bdebyl/kicad-stm32-reflow/stm32-reflow.kicad_pcb

## KiCad design stm32-reflow.kicad_pcb (2022-01-13)

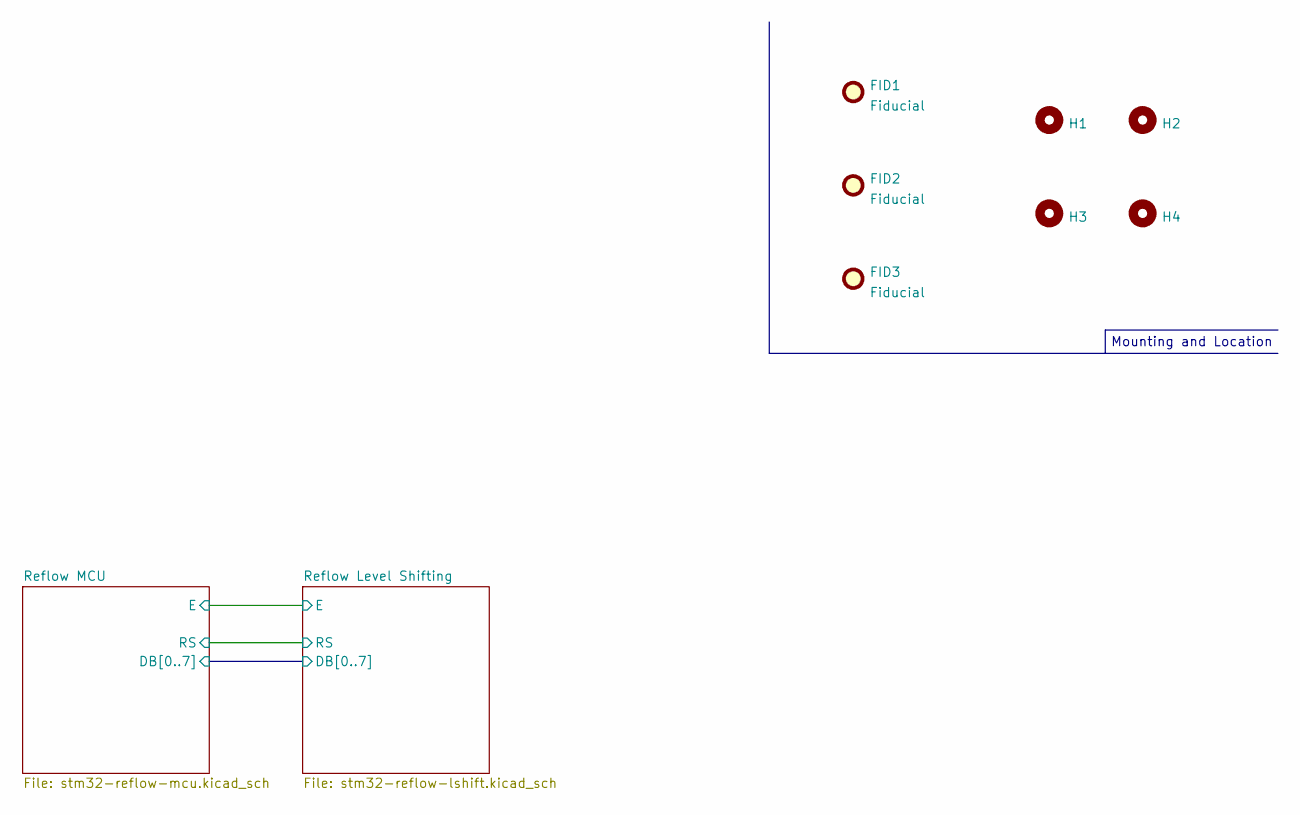
[picture p1: schematic stm32-reflow.kicad_sch, STM32 Reflow Controller]

Parts:
FID1, FID2, FID3: Fiducial; Fiducial_0.75mm_Mask2.25mm
H1, H2, H3, H4: MountingHole; MountingHole_2.7mm_M2.5_Pad_Via

Notes on the sheet:
Mounting and Location

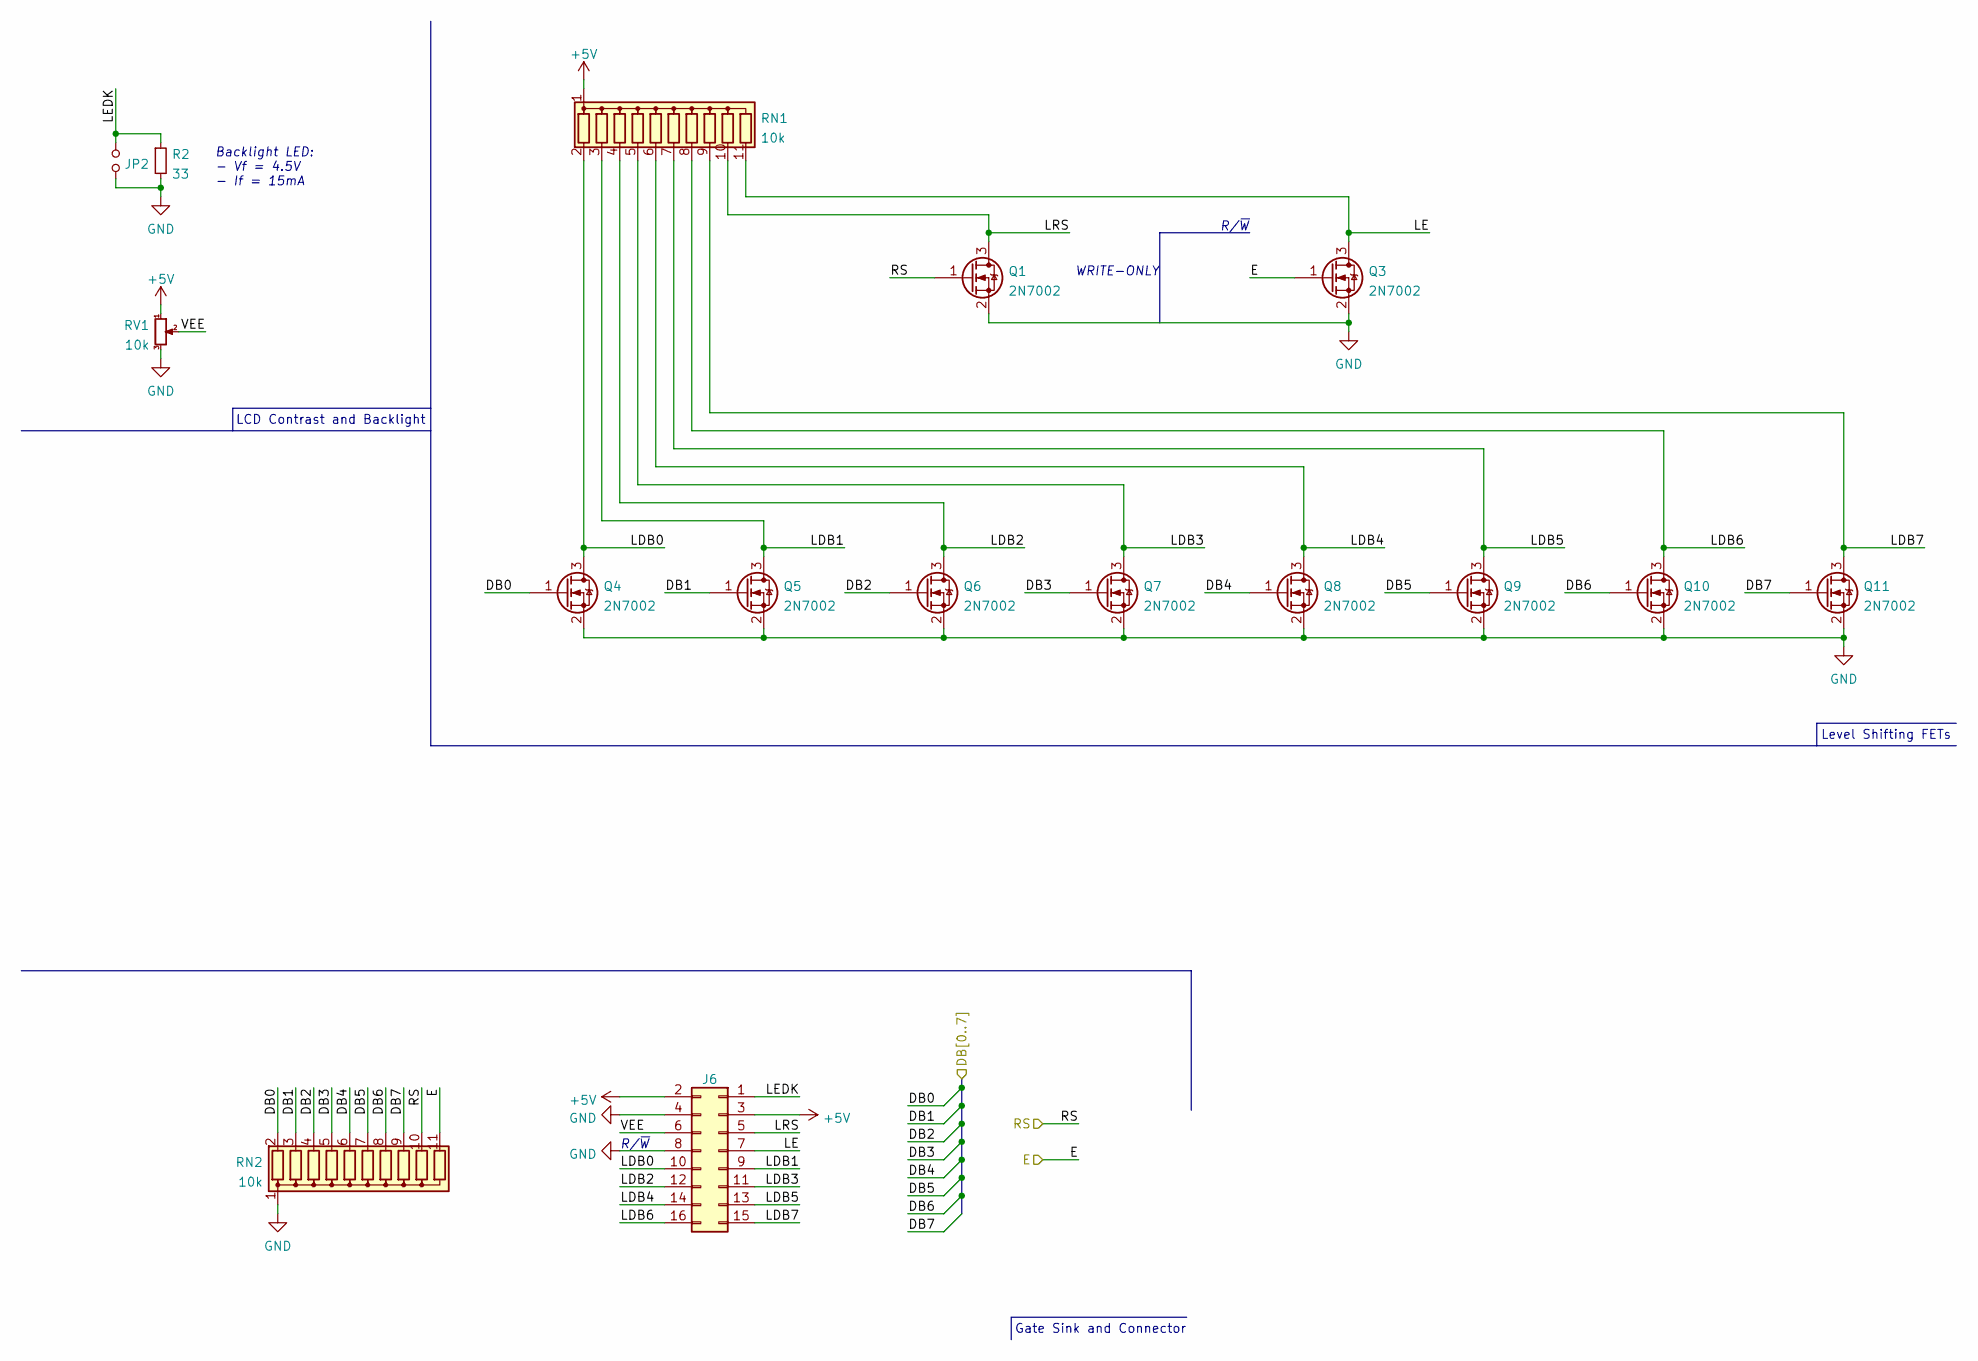
[picture p2: schematic stm32-reflow-lshift.kicad_sch, STM32 Reflow Controller]

Parts:
J6: Conn_02x08_Odd_Even; IDC-Header_2x08_P2.54mm_Vertical; DigiKey Part # S9171-ND
JP2: Jumper_NO_Small; SolderJumper-2_P1.3mm_Open_TrianglePad1.0x1.5mm
Q1, Q3, Q4, Q5, Q6, Q7, Q8, Q9, Q10, Q11: 2N7002; SOT-23; DigiKey Part # 1727-8642-1-ND
R2: 33; R_0805_2012Metric; DigiKey Part # RMCF0805JT33R0CT-ND
RN1, RN2: 10k; R_Array_SIP11; DigiKey Part # 4611X-101-103LF-ND
RV1: 10k; Potentiometer_Bourns_3314G_Vertical; DigiKey Part # ST4ETB103CT-ND

Connections:
+5V: J6.2, J6.3, RN1.1 (common), RV1.1; also elsewhere on the board
/Reflow Level Shifting/DB0: Q4.1 (G), RN2.2 (R1); also elsewhere on the board
/Reflow Level Shifting/DB1: Q5.1 (G), RN2.3 (R2); also elsewhere on the board
/Reflow Level Shifting/DB2: Q6.1 (G), RN2.4 (R3); also elsewhere on the board
/Reflow Level Shifting/DB3: Q7.1 (G), RN2.5 (R4); also elsewhere on the board
/Reflow Level Shifting/DB4: Q8.1 (G), RN2.6 (R5); also elsewhere on the board
/Reflow Level Shifting/DB5: Q9.1 (G), RN2.7 (R6); also elsewhere on the board
/Reflow Level Shifting/DB6: Q10.1 (G), RN2.8 (R7); also elsewhere on the board
/Reflow Level Shifting/DB7: Q11.1 (G), RN2.9 (R8); also elsewhere on the board
/Reflow Level Shifting/E: Q3.1 (G), RN2.11 (R10); also elsewhere on the board
/Reflow Level Shifting/LDB0: J6.10, Q4.3 (D), RN1.2 (R1)
/Reflow Level Shifting/LDB1: J6.9, Q5.3 (D), RN1.3 (R2)
/Reflow Level Shifting/LDB2: J6.12, Q6.3 (D), RN1.4 (R3)
/Reflow Level Shifting/LDB3: J6.11, Q7.3 (D), RN1.5 (R4)
/Reflow Level Shifting/LDB4: J6.14, Q8.3 (D), RN1.6 (R5)
/Reflow Level Shifting/LDB5: J6.13, Q9.3 (D), RN1.7 (R6)
/Reflow Level Shifting/LDB6: J6.16, Q10.3 (D), RN1.8 (R7)
/Reflow Level Shifting/LDB7: J6.15, Q11.3 (D), RN1.9 (R8)
/Reflow Level Shifting/LE: J6.7, Q3.3 (D), RN1.11 (R10)
/Reflow Level Shifting/LEDK: J6.1, JP2.2, R2.1
/Reflow Level Shifting/LRS: J6.5, Q1.3 (D), RN1.10 (R9)
/Reflow Level Shifting/RS: Q1.1 (G), RN2.10 (R9); also elsewhere on the board
/Reflow Level Shifting/VEE: J6.6, RV1.2
GND: J6.4, J6.8, JP2.1, Q1.2 (S), Q3.2 (S), Q4.2 (S), Q5.2 (S), Q6.2 (S), Q7.2 (S), Q8.2 (S), Q9.2 (S), Q10.2 (S), Q11.2 (S), R2.2, RN2.1 (common), RV1.3; also elsewhere on the board

Notes on the sheet:
Backlight LED: - Vf = 4.5V - If = 15mA
LCD Contrast and Backlight
R/~{W}
WRITE-ONLY
Gate Sink and Connector
Level Shifting FETs

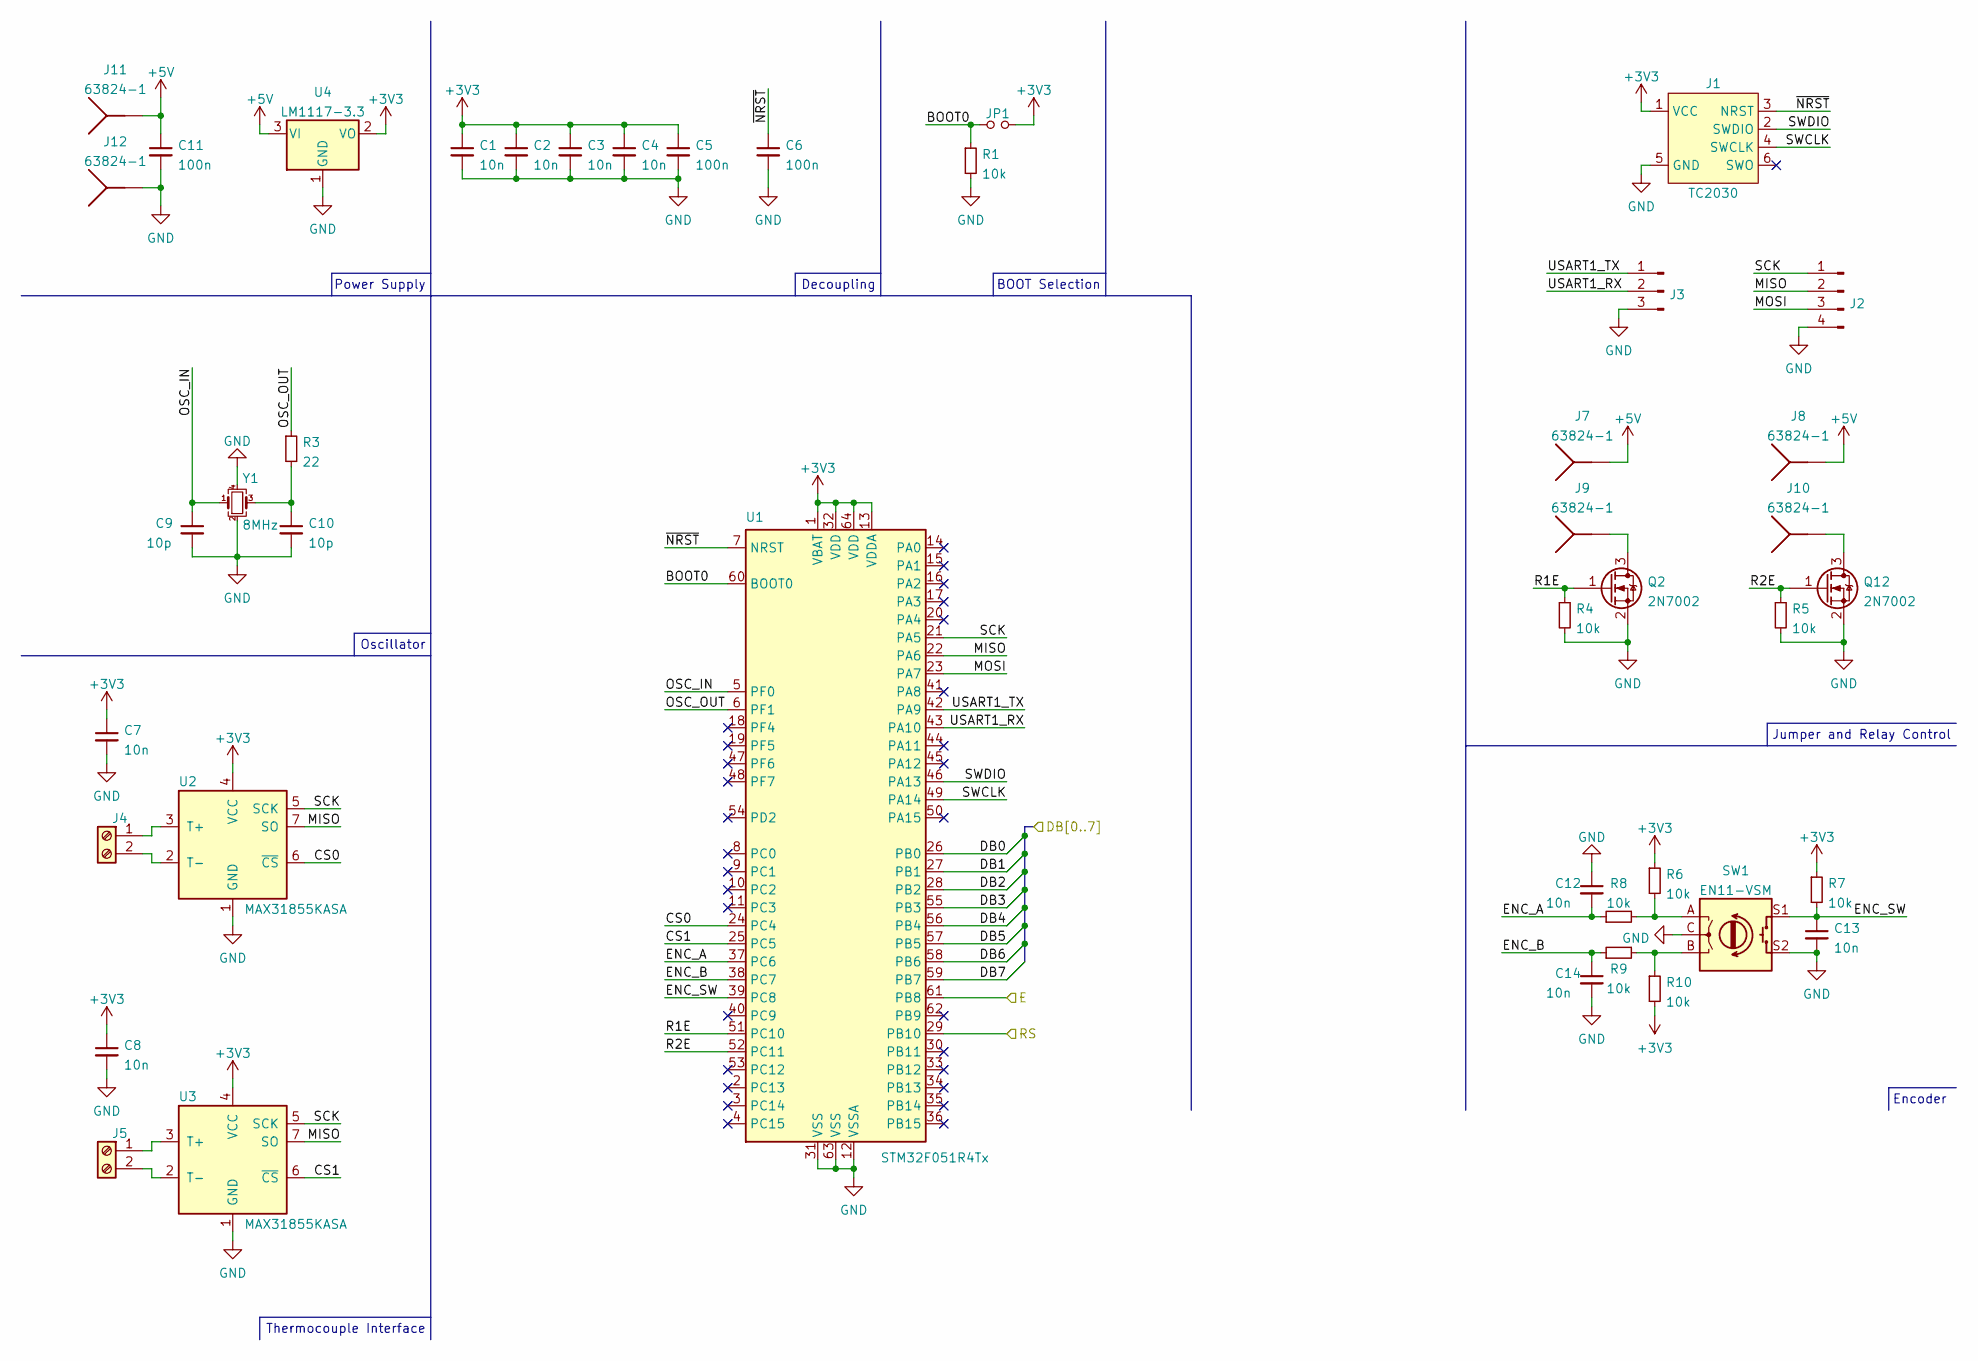
[picture p3: schematic stm32-reflow-mcu.kicad_sch, STM32 Reflow Controller]

Parts:
C1, C2, C3, C4, C7, C8, C12, C13, C14: 10n; C_0603_1608Metric; DigiKey Part # 732-8007-2-ND
C5, C6, C11: 100n; C_0805_2012Metric; DigiKey Part # 732-7760-2-ND
C9, C10: 10p; C_0603_1608Metric; DigiKey Part # 732-7760-2-ND
J1: TC2030; TC2030-IDC-NL
J2: Conn_01x04_Male; PinHeader_1x04_P2.54mm_Vertical
J3: Conn_01x03_Male; PinHeader_1x03_P2.54mm_Vertical
J4, J5: Screw_Terminal_01x02; TerminalBlock_TE_282834-2_1x02_P2.54mm_Horizontal; DigiKey Part # ED10561-ND
J7, J8, J9, J10, J11, J12: 63824-1; CONN_63824-1; DigiKey Part # A29938CT-ND
JP1: Jumper_NO_Small; SolderJumper-2_P1.3mm_Open_Pad1.0x1.5mm
Q2, Q12: 2N7002; SOT-23; DigiKey Part # 1727-8642-1-ND
R1, R4, R5, R6, R7, R8, R9, R10: 10k; R_0603_1608Metric; DigiKey Part # RMCF0603JT10K0TR-ND
R3: 22; R_0603_1608Metric; DigiKey Part # CR0603-JW-220ELFTR-ND
SW1: EN11-VSM; EN11-VSM1AF20; DigiKey Part # 987-1192-ND
U1: STM32F051R4Tx; LQFP-64_10x10mm_P0.5mm
U2, U3: MAX31855KASA; SOIC-8_3.9x4.9mm_P1.27mm
U4: LM1117-3.3; SOT-223-3_TabPin2; DigiKey Part # 497-3455-2-ND
Y1: 8MHz; Crystal_SMD_5032-4Pin_5.0x3.2mm; DigiKey Part # 1923-LFXTAL061627REELCT-ND

Connections:
+3V3: C1.1, C2.1, C3.1, C4.1, C5.1, C7.1, C8.1, J1.1 (VCC), JP1.2, R6.1, R7.1, R10.2, U1.1 (VBAT), U1.13 (VDDA), U1.32 (VDD), U1.64 (VDD), U2.4 (VCC), U3.4 (VCC), U4.2 (VO)
+5V: C11.1, J7.1, J7.2, J8.1, J8.2, J11.1, J11.2, U4.3 (VI); also elsewhere on the board
/Reflow Level Shifting/DB0: U1.26 (PB0); also elsewhere on the board
/Reflow Level Shifting/DB1: U1.27 (PB1); also elsewhere on the board
/Reflow Level Shifting/DB2: U1.28 (PB2); also elsewhere on the board
/Reflow Level Shifting/DB3: U1.55 (PB3); also elsewhere on the board
/Reflow Level Shifting/DB4: U1.56 (PB4); also elsewhere on the board
/Reflow Level Shifting/DB5: U1.57 (PB5); also elsewhere on the board
/Reflow Level Shifting/DB6: U1.58 (PB6); also elsewhere on the board
/Reflow Level Shifting/DB7: U1.59 (PB7); also elsewhere on the board
/Reflow Level Shifting/E: U1.61 (PB8); also elsewhere on the board
/Reflow Level Shifting/RS: U1.29 (PB10); also elsewhere on the board
/Reflow MCU/BOOT0: JP1.1, R1.1, U1.60 (BOOT0)
/Reflow MCU/CS0: U1.24 (PC4), U2.6 (~CS)
/Reflow MCU/CS1: U1.25 (PC5), U3.6 (~CS)
/Reflow MCU/ENC_A: C12.2, R8.1, U1.37 (PC6)
/Reflow MCU/ENC_B: C14.1, R9.1, U1.38 (PC7)
/Reflow MCU/ENC_SW: C13.1, R7.2, SW1.S1, U1.39 (PC8)
/Reflow MCU/MISO: J2.2, U1.22 (PA6), U2.7 (SO), U3.7 (SO)
/Reflow MCU/MOSI: J2.3, U1.23 (PA7)
/Reflow MCU/OSC_IN: C9.1, U1.5 (PF0), Y1.1
/Reflow MCU/OSC_OUT: R3.1, U1.6 (PF1)
/Reflow MCU/R1E: Q2.1 (G), R4.1, U1.51 (PC10)
/Reflow MCU/R2E: Q12.1 (G), R5.1, U1.52 (PC11)
/Reflow MCU/SCK: J2.1, U1.21 (PA5), U2.5 (SCK), U3.5 (SCK)
/Reflow MCU/SWCLK: J1.4 (SWCLK), U1.49 (PA14)
/Reflow MCU/SWDIO: J1.2 (SWDIO), U1.46 (PA13)
/Reflow MCU/USART1_RX: J3.2, U1.43 (PA10)
/Reflow MCU/USART1_TX: J3.1, U1.42 (PA9)
/Reflow MCU/~NRST: C6.1, J1.3 (NRST), U1.7 (NRST)
GND: C1.2, C2.2, C3.2, C4.2, C5.2, C6.2, C7.2, C8.2, C9.2, C10.2, C11.2, C12.1, C13.2, C14.2, J1.5 (GND), J2.4, J3.3, J12.1, J12.2, Q2.2 (S), Q12.2 (S), R1.2, R4.2, R5.2, SW1.C, SW1.S2, U1.12 (VSSA), U1.31 (VSS), U1.63 (VSS), U2.1 (GND), U3.1 (GND), U4.1 (GND), Y1.2, Y1.4; also elsewhere on the board
unnamed: C10.1, R3.2, Y1.3
unnamed: J4.1, U2.3 (T+)
unnamed: J4.2, U2.2 (T-)
unnamed: J5.1, U3.3 (T+)
unnamed: J5.2, U3.2 (T-)
unnamed: J9.1, J9.2, Q2.3 (D)
unnamed: J10.1, J10.2, Q12.3 (D)
unnamed: R6.2, R8.2, SW1.A
unnamed: R9.2, R10.1, SW1.B

Notes on the sheet:
Power Supply
Oscillator
Thermocouple Interface
Decoupling
BOOT Selection
Encoder
Jumper and Relay Control

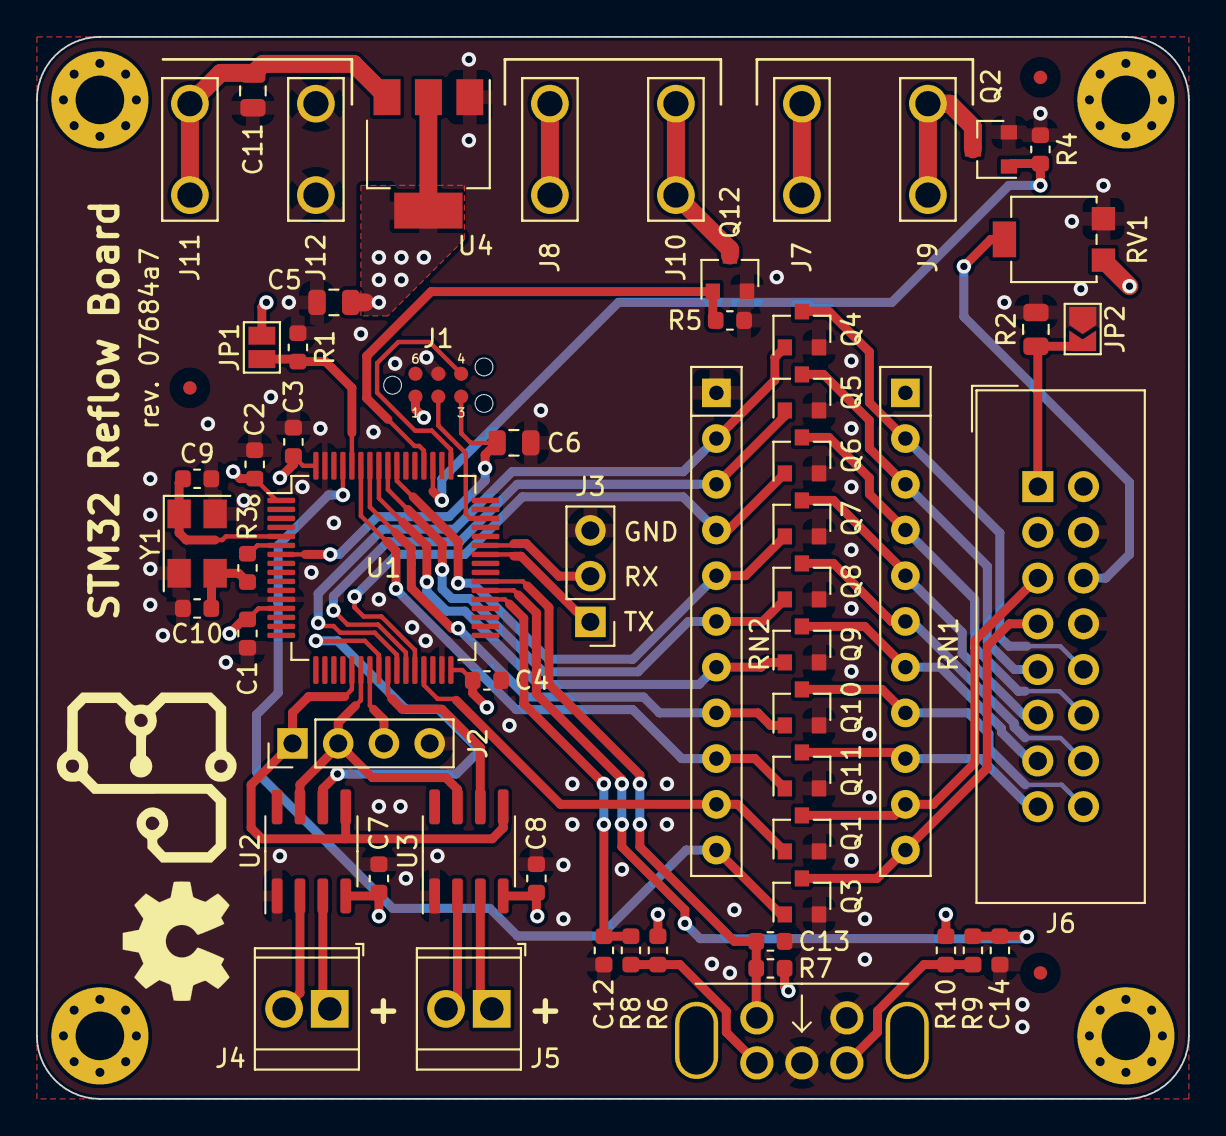
[picture p4: board stm32-reflow.kicad_pcb from above]

Board: 4 copper layers, 64.0 x 59.0 mm, 66 parts (0 on the bottom side), 52 nets.
