bdebyl/kicad-stm32-reflow/(commit log)

2021-11-26 initial routing, added power supply source
    [stm32-reflow-lshift.kicad_sch, stm32-reflow-mcu.kicad_sch, stm32-reflow-psu.kicad_sch, stm32-reflow.kicad_pcb, stm32-reflow.kicad_sch]
2021-11-26 finalized routing and circuit schematic (so far)
    [stm32-reflow-lshift.kicad_sch, stm32-reflow-mcu.kicad_sch, stm32-reflow-psu.kicad_sch, stm32-reflow.kicad_pcb, stm32-reflow.kicad_sch]
2021-11-26 fixed orientation of the LCD IDC connector
    [stm32-reflow-lshift.kicad_sch, stm32-reflow.kicad_pcb]
2021-11-26 ERC and DRC fixes
    [stm32-reflow-lshift.kicad_sch, stm32-reflow-mcu.kicad_sch, stm32-reflow-psu.kicad_sch, stm32-reflow.kicad_pcb]
2021-11-26 added additional silkscreening
    [stm32-reflow.kicad_pcb]
2021-11-26 downsized resistor network to 10
    [stm32-reflow-lshift.kicad_sch, stm32-reflow-mcu.kicad_sch, stm32-reflow.kicad_pcb, stm32-reflow.kicad_sch]
2021-11-26 consolidated schematics for clarity, labeling and organization
    [stm32-reflow-lshift.kicad_sch, stm32-reflow-mcu.kicad_sch, stm32-reflow-psu.kicad_sch, stm32-reflow.kicad_pcb, stm32-reflow.kicad_sch]
2021-11-26 added missign Oscillator schematic label
    [stm32-reflow-mcu.kicad_sch]
2021-11-26 fixed labeling of R1E & R2E
    [stm32-reflow-lshift.kicad_sch, stm32-reflow-mcu.kicad_sch]
2021-11-26 moved silkscreening around, added labels
    [stm32-reflow.kicad_pcb]
2021-11-26 added encoder interface
    [stm32-reflow-lshift.kicad_sch, stm32-reflow-mcu.kicad_sch, stm32-reflow.kicad_pcb, stm32-reflow.kicad_sch]
2021-11-26 organized schematic more, fixed net naming of rw
    [stm32-reflow-lshift.kicad_sch, stm32-reflow-mcu.kicad_sch, stm32-reflow.kicad_pcb, stm32-reflow.kicad_sch]
2021-11-29 finalized design for production
    [stm32-reflow.kicad_pcb]
2021-11-29 added revision label, finalized for fabrication
    [stm32-reflow-lshift.kicad_sch, stm32-reflow-mcu.kicad_sch, stm32-reflow.kicad_pcb, stm32-reflow.kicad_sch]
2021-12-16 updated bom to reflect non-backordered parts
    [stm32-reflow-lshift.kicad_sch, stm32-reflow-mcu.kicad_sch, stm32-reflow.csv, stm32-reflow.kicad_pcb, stm32-reflow.kicad_sch]
2022-01-18 updated board for proper kicad6.0 compati
    [stm32-reflow-lshift.kicad_sch, stm32-reflow-mcu.kicad_sch, stm32-reflow.kicad_sch]
